WEGA-project/wega-mixer/images/completed-mixers/readme.md

# Законченные варианты миксеров и примеры корпусов

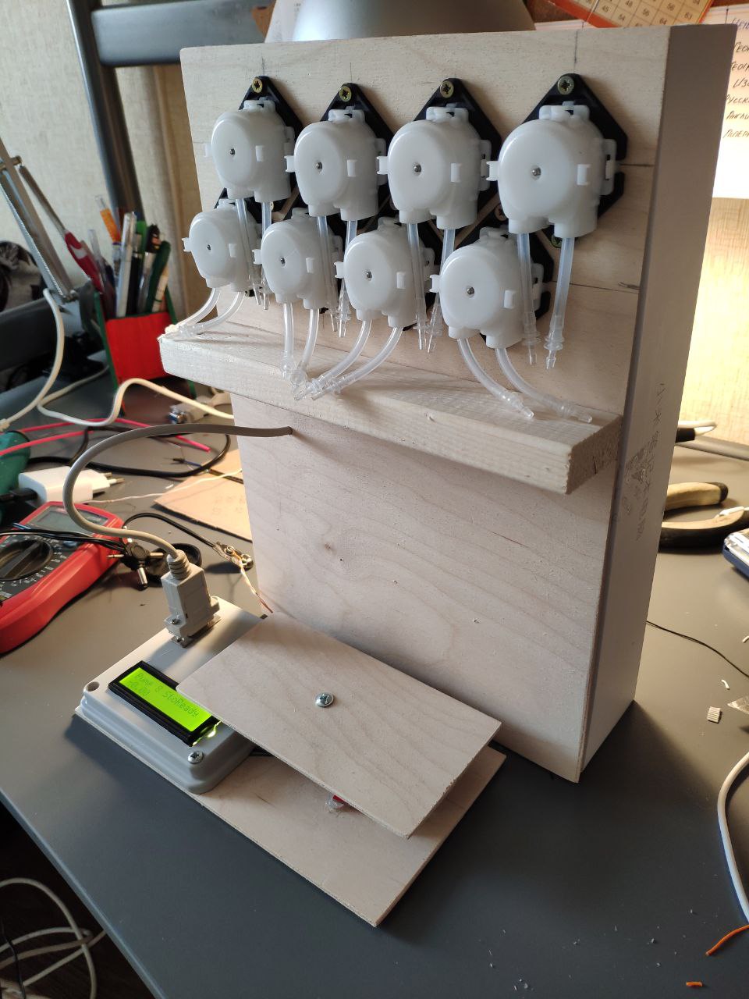
[picture p12: images/completed-mixers/1.jpg]
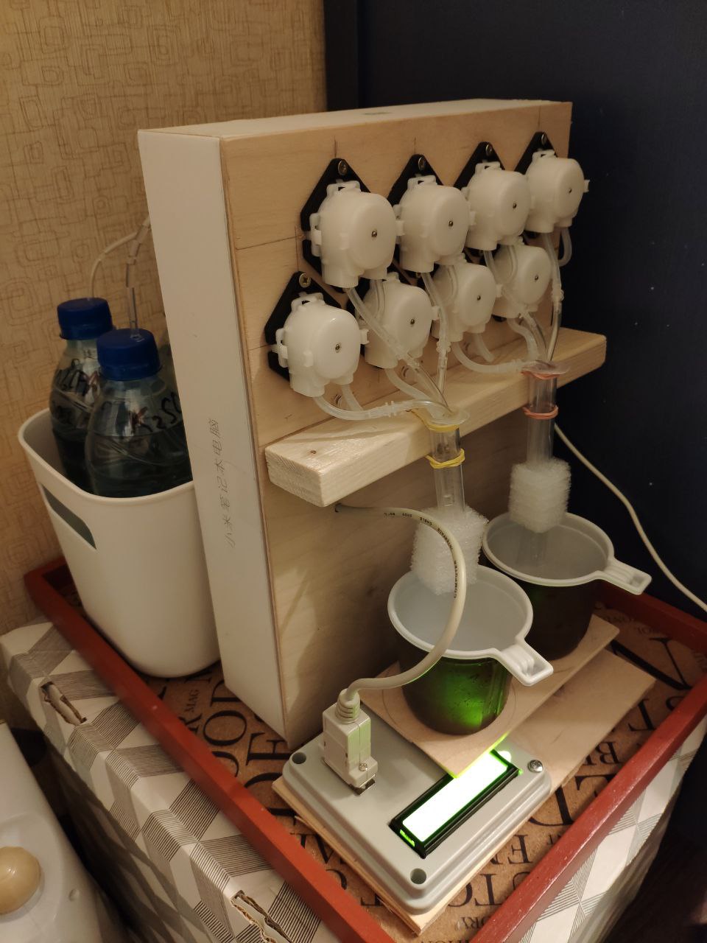
[picture p13: images/completed-mixers/1-1.jpg]
<a href="1.jpg"><a href="1-1.jpg">

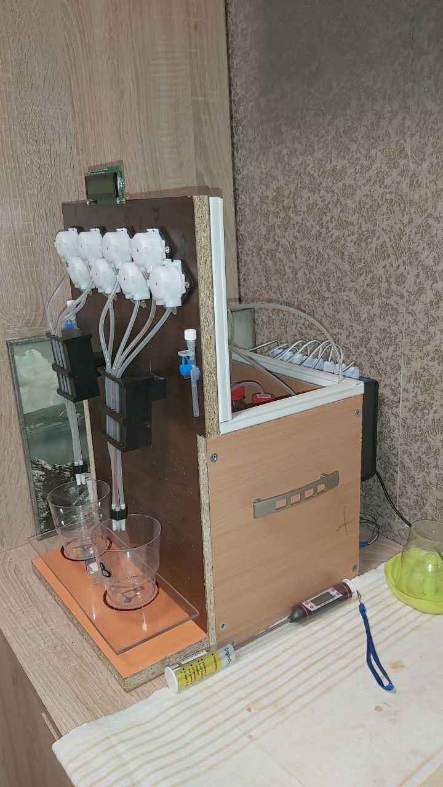
[picture p14: images/completed-mixers/v_1.jpg]
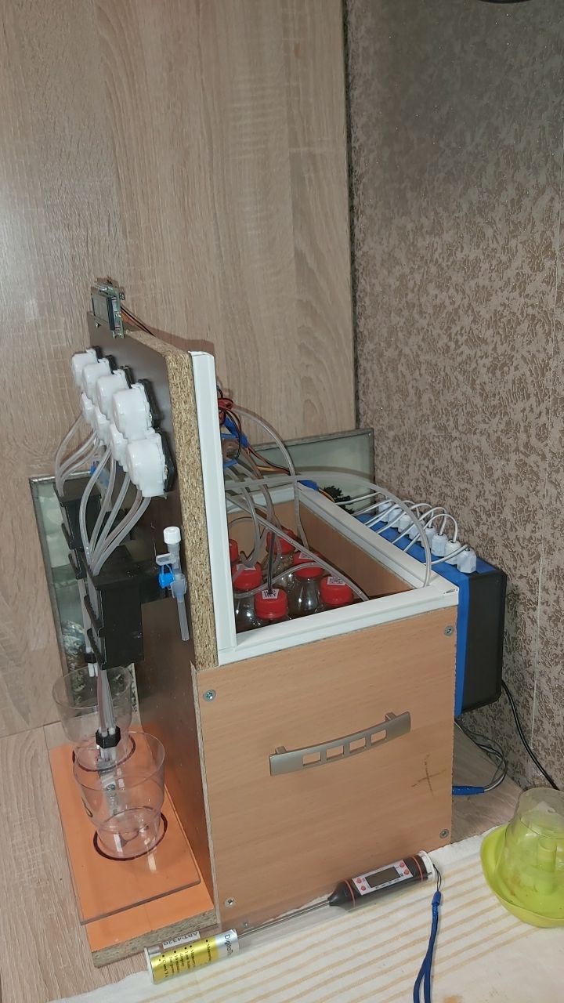
[picture p15: images/completed-mixers/v_2.jpg]


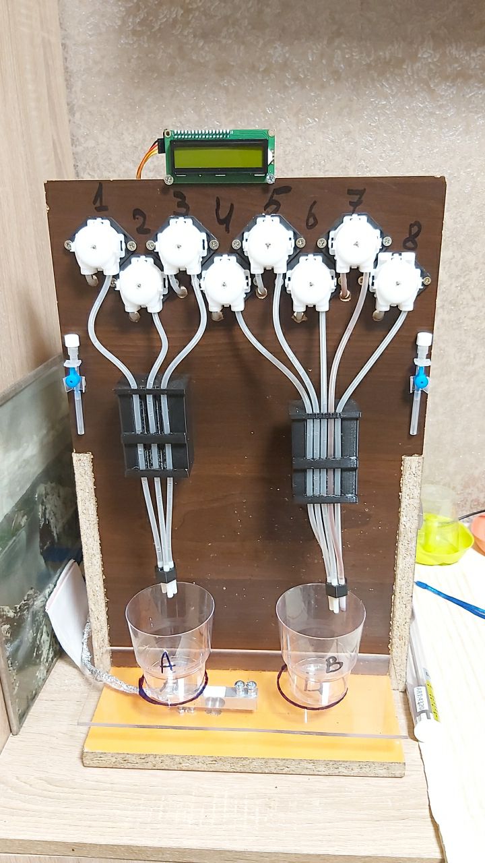
[picture p16: images/completed-mixers/v_3.jpg]
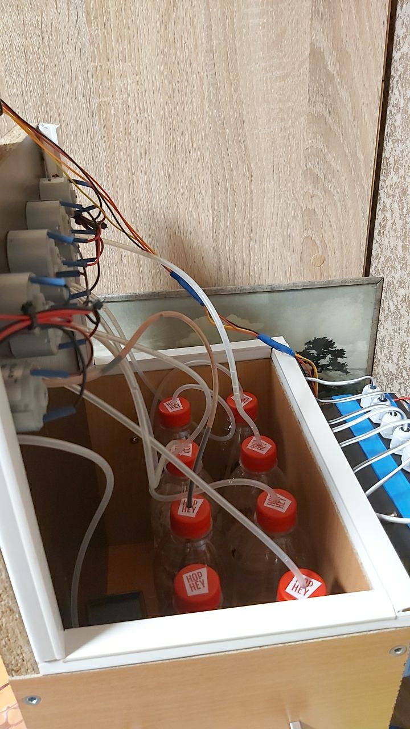
[picture p17: images/completed-mixers/v_4.jpg]


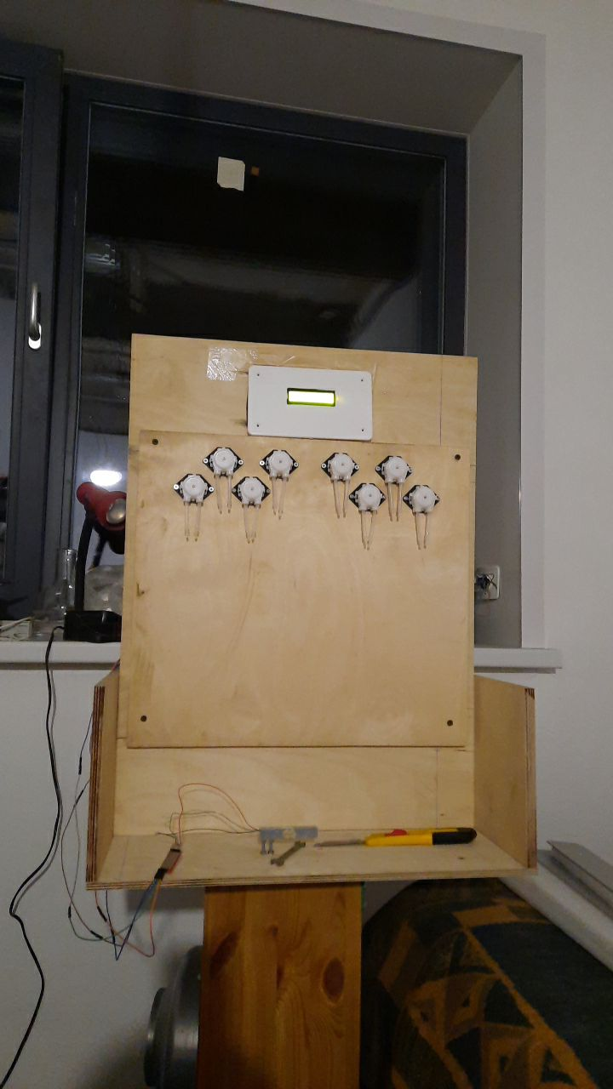
[picture p18: images/completed-mixers/3.jpg]


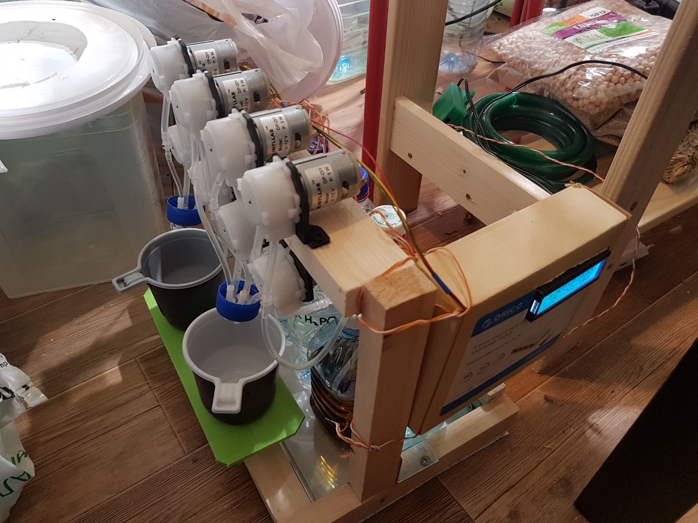
[picture p19: images/completed-mixers/2.jpg]
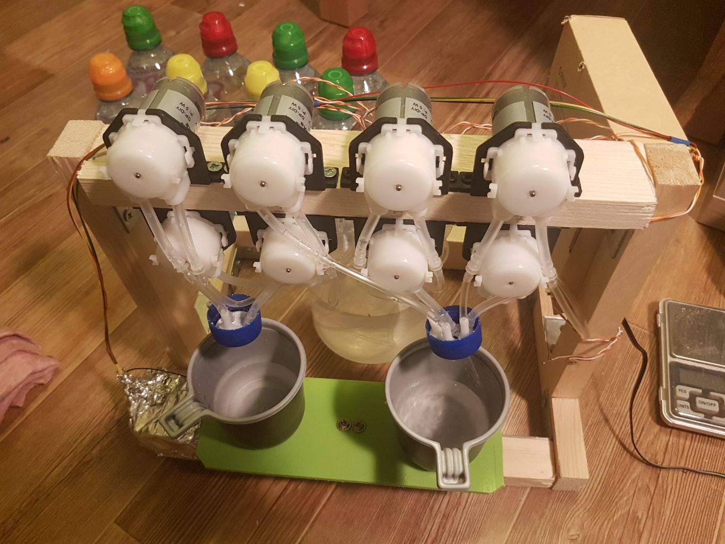
[picture p20: images/completed-mixers/4.jpg]


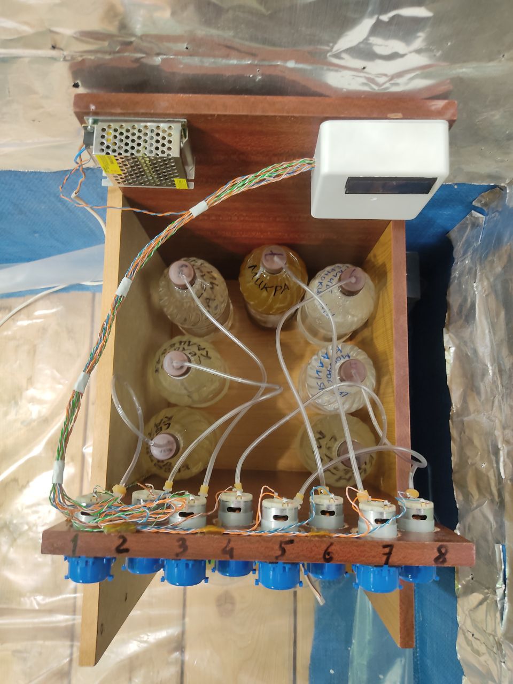
[picture p21: images/completed-mixers/6.jpg]
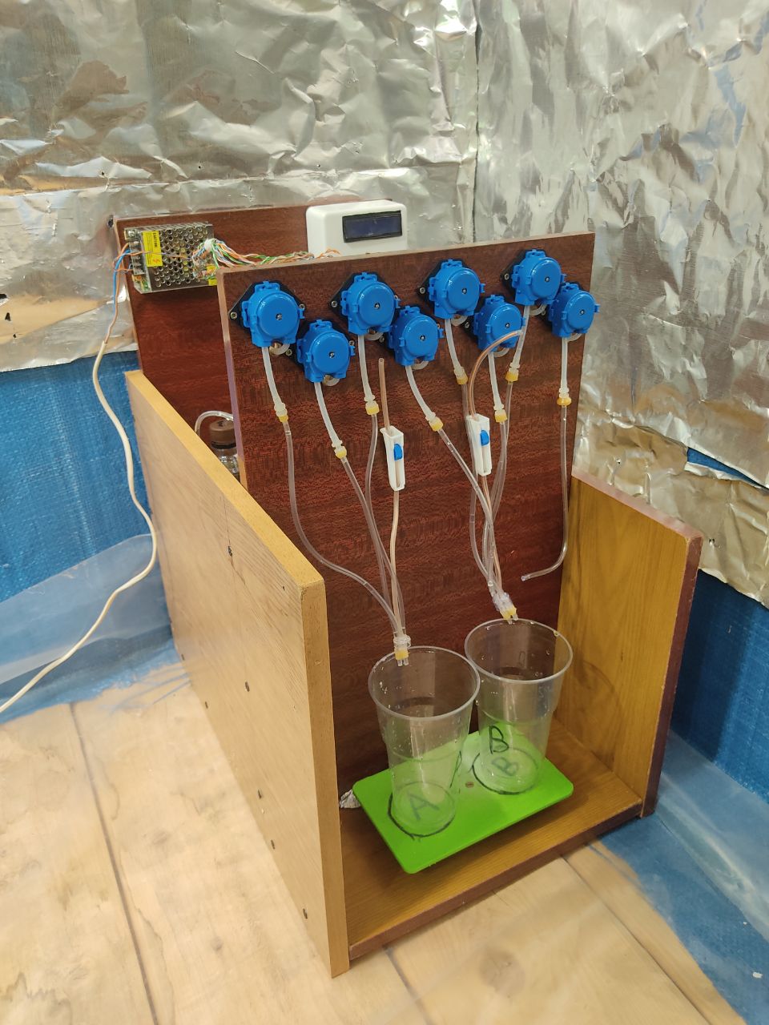
[picture p22: images/completed-mixers/8.jpg]


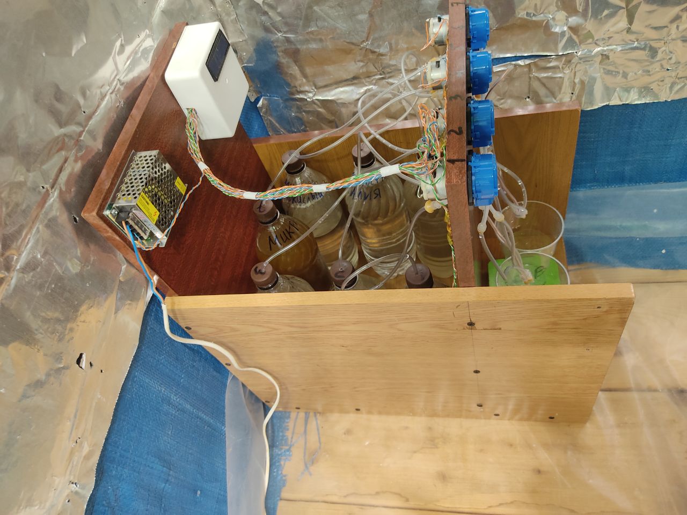
[picture p23: images/completed-mixers/7.jpg]
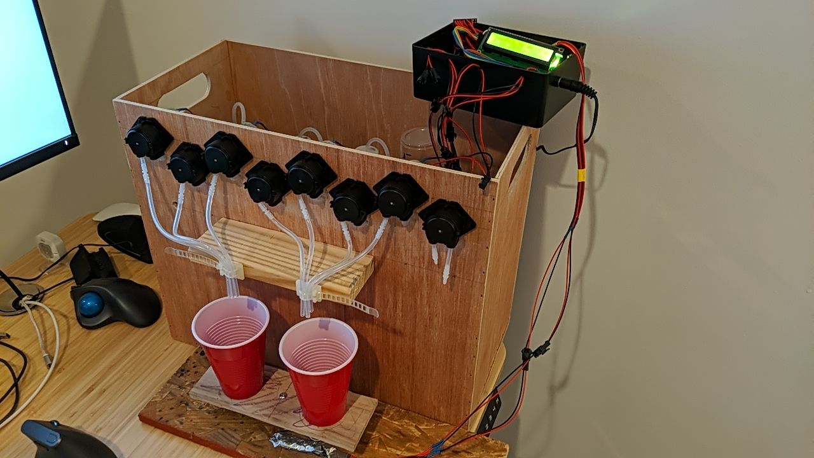
[picture p24: images/completed-mixers/15.jpg]


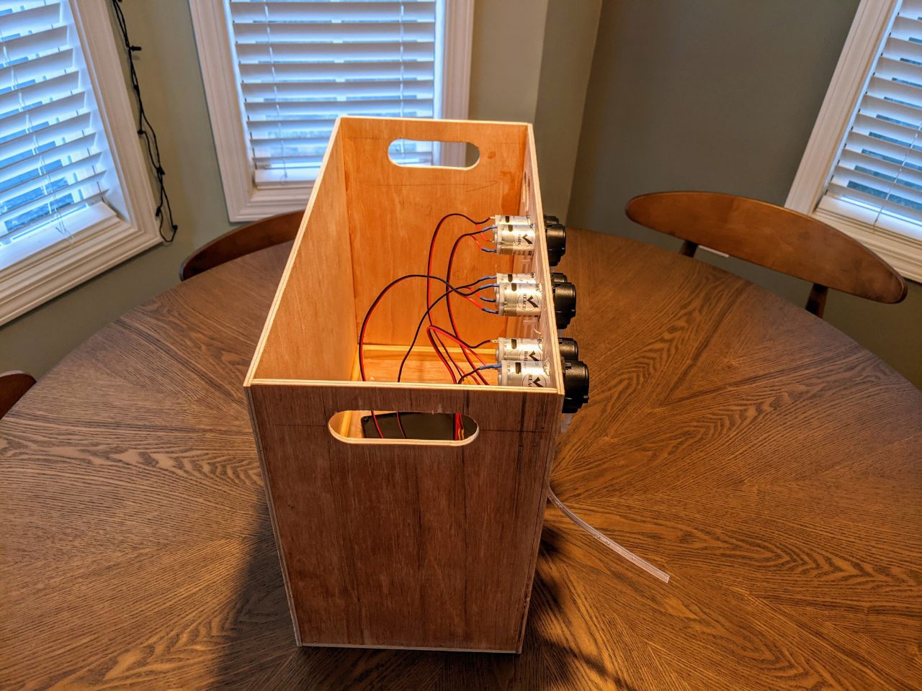
[picture p25: images/completed-mixers/9.jpg]
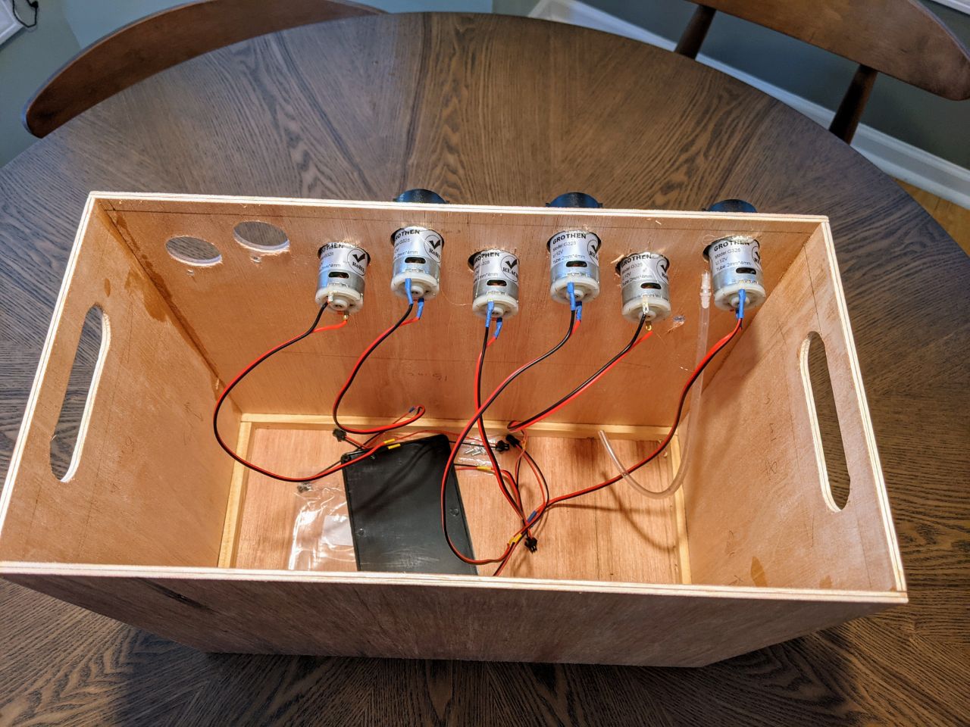
[picture p26: images/completed-mixers/10.jpg]


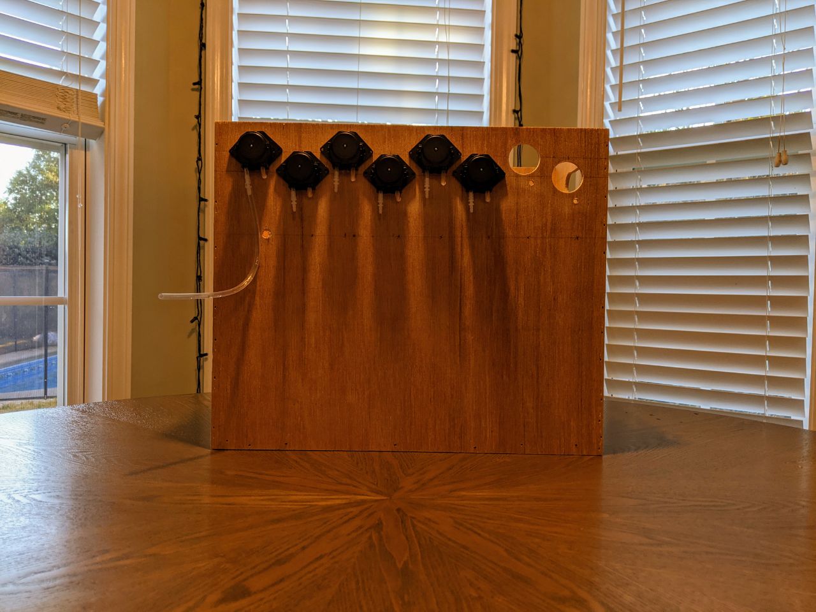
[picture p27: images/completed-mixers/11.jpg]
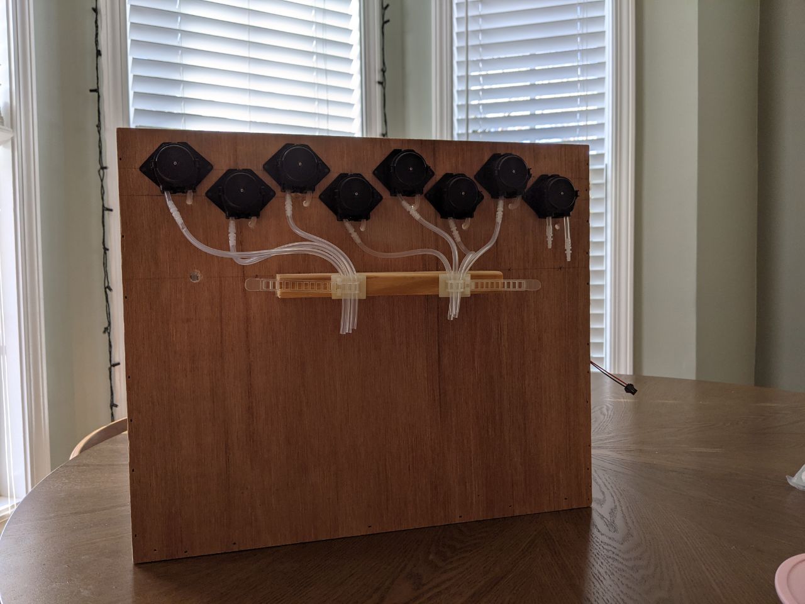
[picture p28: images/completed-mixers/12.jpg]


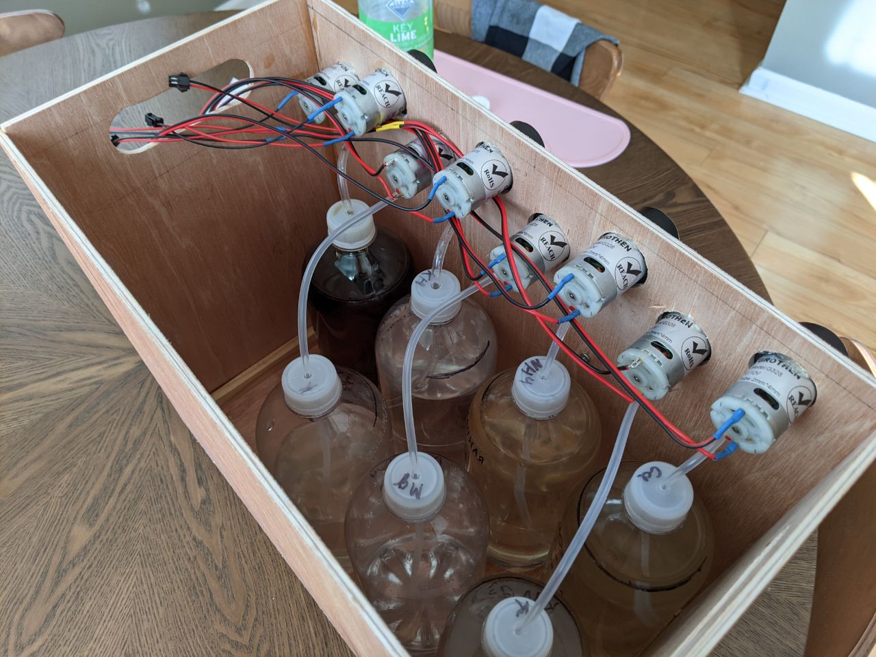
[picture p29: images/completed-mixers/13.jpg]
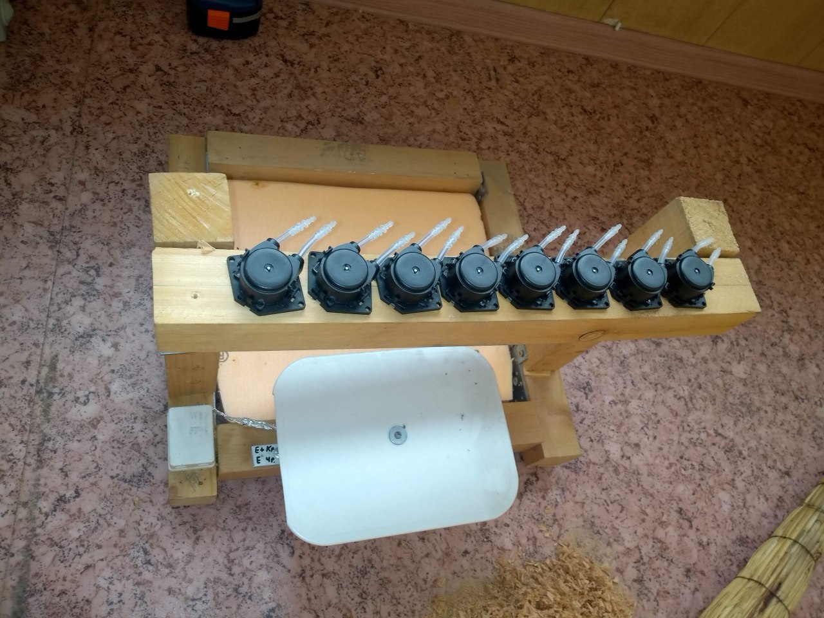
[picture p30: images/completed-mixers/16.jpg]


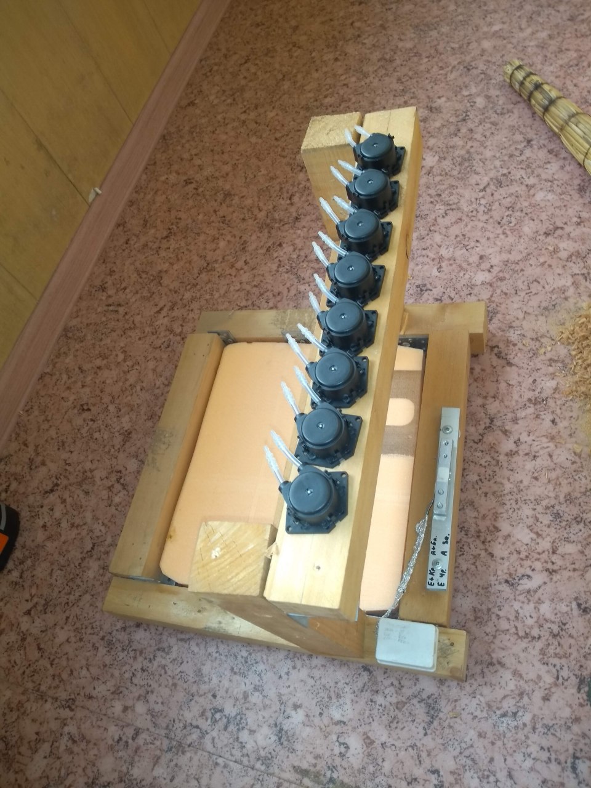
[picture p31: images/completed-mixers/17.jpg]
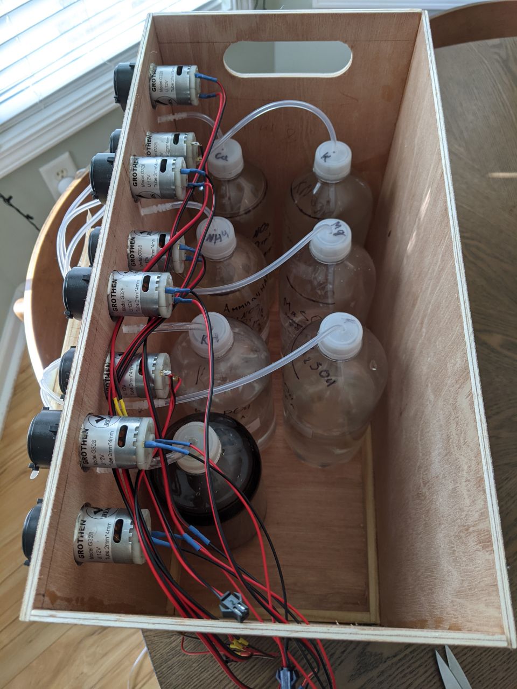
[picture p32: images/completed-mixers/14.jpg]


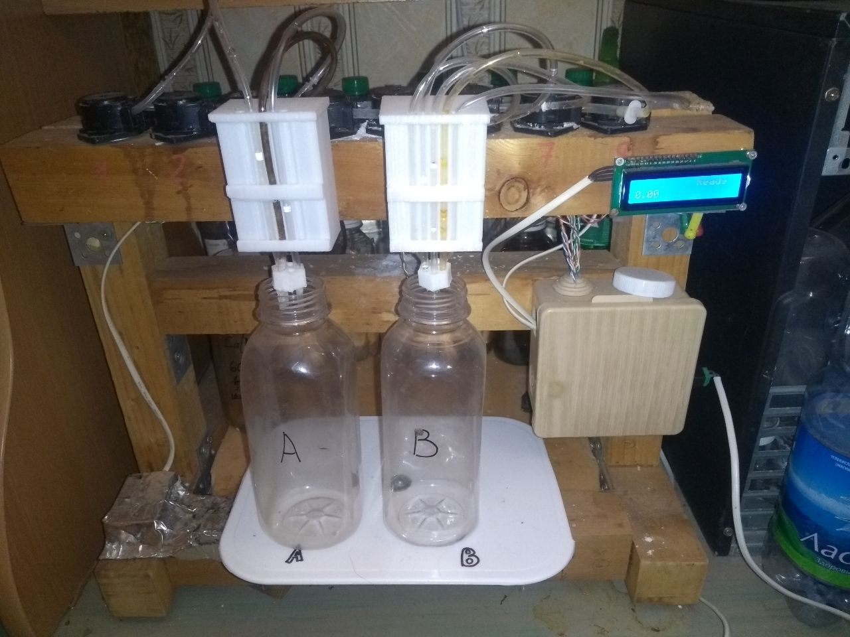
[picture p33: images/completed-mixers/18.jpg]
