WEGA-project/wega-mixer/images/pio-boards-select.png

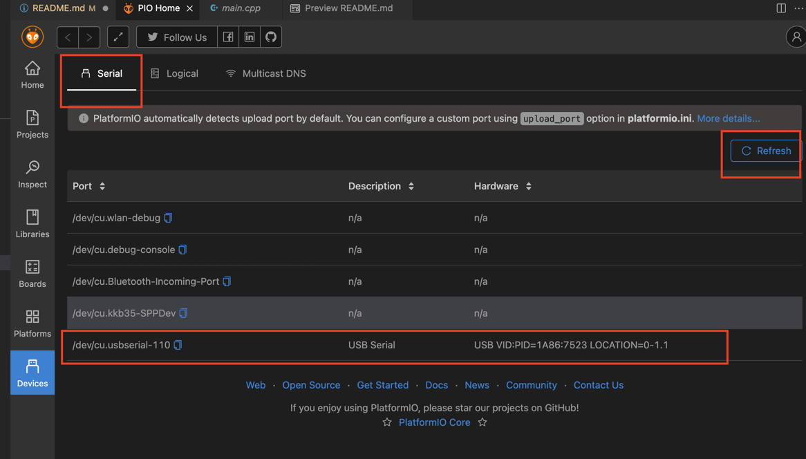
images/pio-boards-select.png
