WEGA-project/wega-mixer/images/pio-boards.png

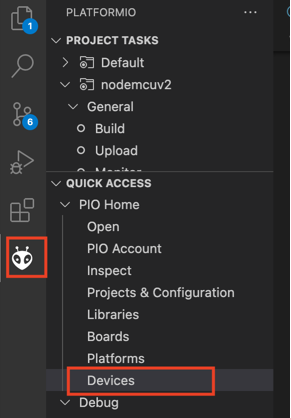
images/pio-boards.png
