WEGA-project/wega-mixer/images/wega-ecosystem.jpg

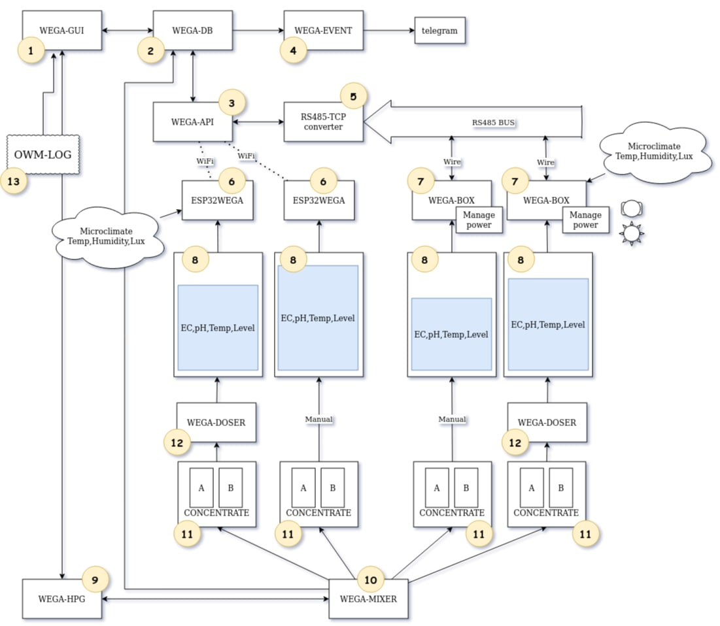
images/wega-ecosystem.jpg
