WEGA-project/wega-mixer/scheme/Schematic_wega-mixer.pdf

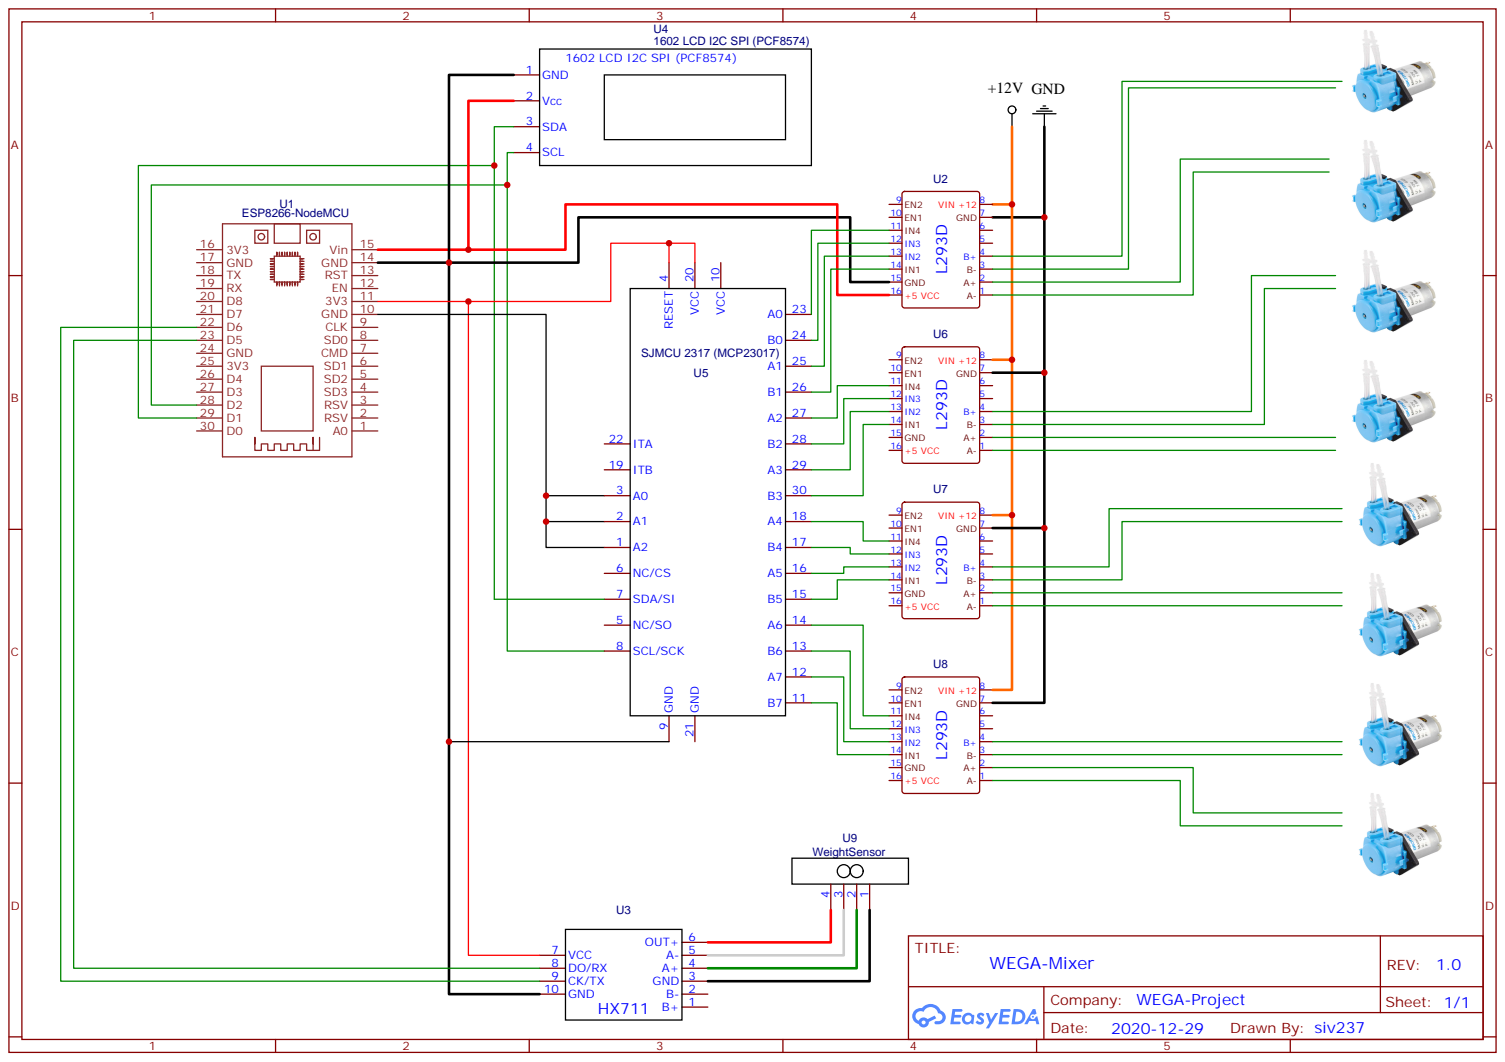
[picture p37: page 1]
