WEGA-project/wega-mixer/scheme/scheme-wega-mixer.pdf

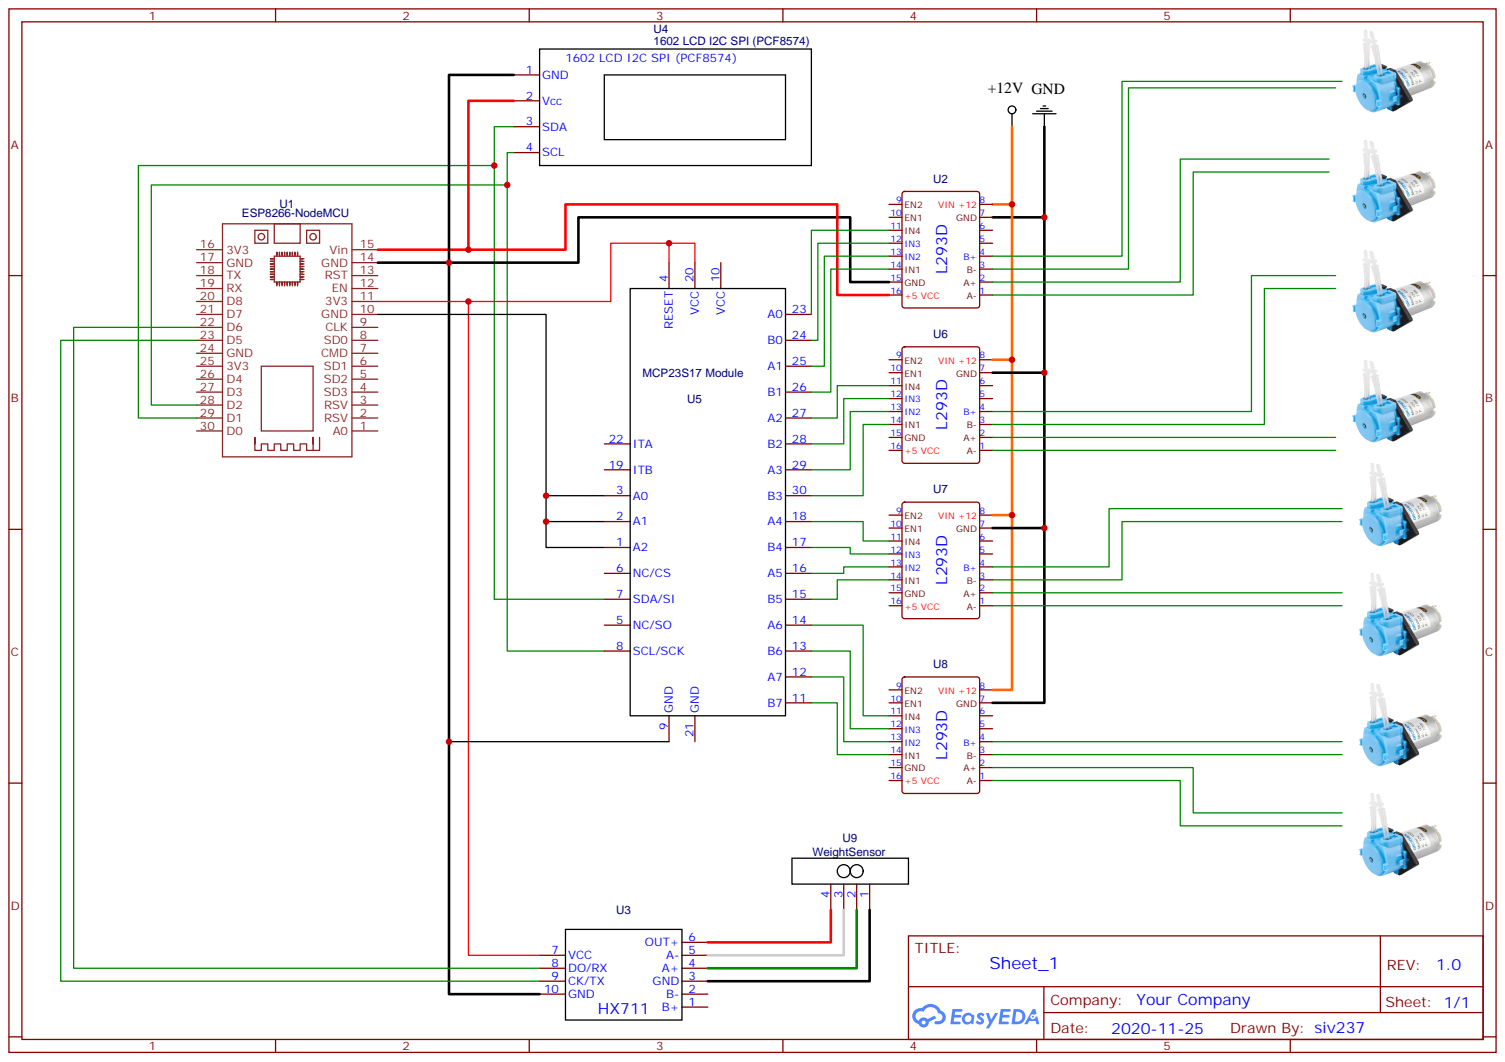
[picture p38: page 1]
