WEGA-project/wega-mixer/(list of files, drawings)

Other design files:
scheme/EasyEDA-wega-mixer.json
