WEGA-project/wega-mixer/(commit log)

2020-12-08 Первая заливка
    [EasyEDA-wega-mixer.json]
2020-12-29 Deleted: old files, not relevant
    [EasyEDA-wega-mixer.json]
2020-12-30 Updated: added install board process
2020-12-31 Разделил переменные и основной код
2020-12-31 Скорректирован формат записи соотвествий помп и портов на плате расширения
2020-12-31 настройки помп вынесены в заголовочный файл
2020-12-31 Вынес url wega-api
2021-01-01 Версия 1.01 Добавлена WEB форма весы (SCALES)
2021-01-02 Updated: how to configure pump ports
2021-01-04 Версия FW 1.02 Добавлена форма определения коэффициента калибровки scale_calibration
2021-01-04 1.04 Изменен алгоритм продувки, расширена форма калибровки
2021-01-04 Изменил форму изготовления для более удобного контроля
2021-01-04 Исправлена проблема, из за которой при пропуске последнего насоса веб интерфейс не переходил в готовность
2021-01-04 Версия обновлена до 1.041
2021-01-05 Добавлена функция вывода ip адреса при включении миксера на встроенный экран
2021-01-05 fw:1.044 Добавлен режим отображения процесса изготовления на веб странице с автообновлением информации по статусу.
2021-01-09 fw:1.045 Ссылки в интерфейсе заменены кнопками, добавлена кнопка установки на 0 в режиме весов.
2021-01-10 Улучшена структура программы, файл стилей оформления вынесен отдельно
2021-03-20 Update README.md
    MCP23S17 - это SPI вариант, правильнее MCP23017
2021-04-04 Верся 1.049 Добавлен подсчет итоговых объемов А и B
2021-04-22 Версия 1.050 добавлен счетчик времени
2021-04-22 работа с альфой
2021-04-23 Предварительно зафиналиная альфа 1.1
2021-04-23 Для альфа 1.1 оптимизирован быстрый налив, иногда из-за вибрации он пропускался и сразу переходило к капельному.
2021-04-24 тюнинг быстрого налива для альфы 1.1
2021-04-25 Альфа 1.1 исправлена критическая ошибка, из за которой насос мог внезапно остановиться при быстром наливе и не возобновить работу.
2021-07-02 Альфа обновлена до 1.11. Правки для совместимости с hpg и wega. Правки отображения на встроенном дисплее ожидаемый вес. Ускорена отработка цикла в случае если часть насосов не должны включаться Добав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
2022-01-02 Updated: added windows drivers url
2022-04-11 Fixed error handling for readScales
    [func.h]
2022-07-24 Добавление авторизации для записи истории на wega-server
2022-07-24 Добавлен толчек насоса при капельном доливе для защиты от заклинивания
2022-07-24 Возврат форматирования
